suchanekj/-Sight/Schematics/Model/Robot.pdf

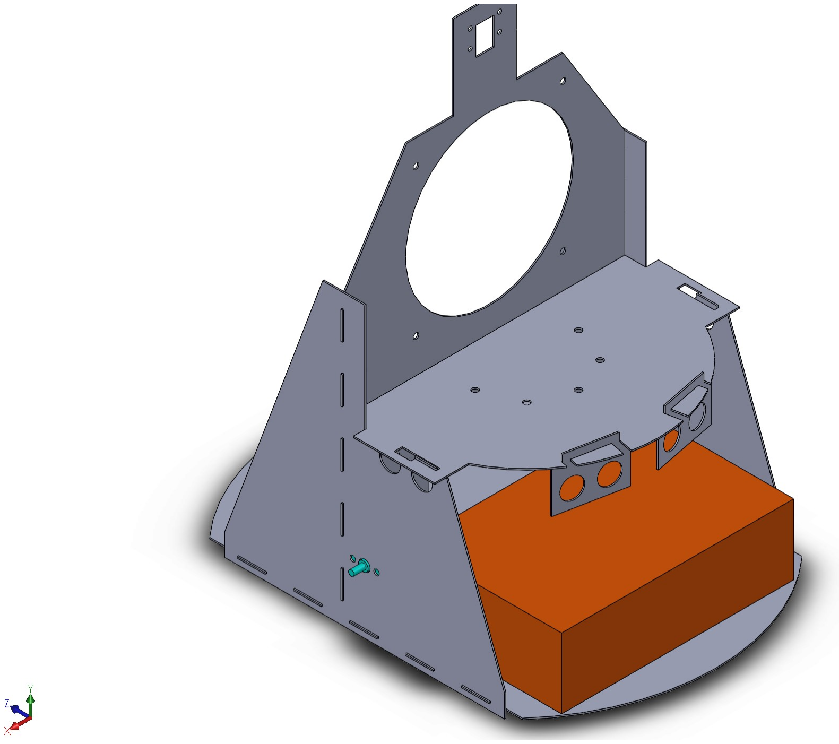
[picture p1: page 1]
