suchanekj/-Sight/Schematics/Circuit/board.png

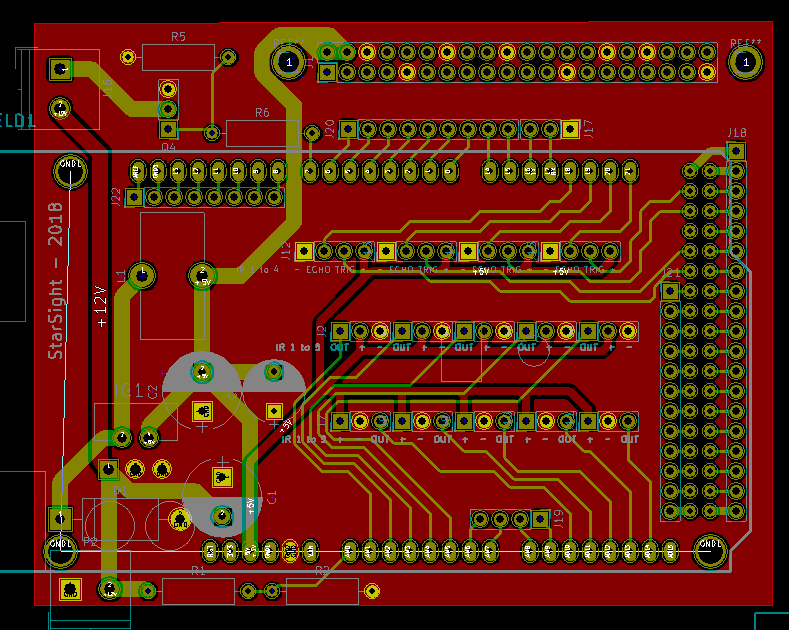
Schematics/Circuit/board.png
