suchanekj/-Sight/Schematics/Model/Robot.jpg

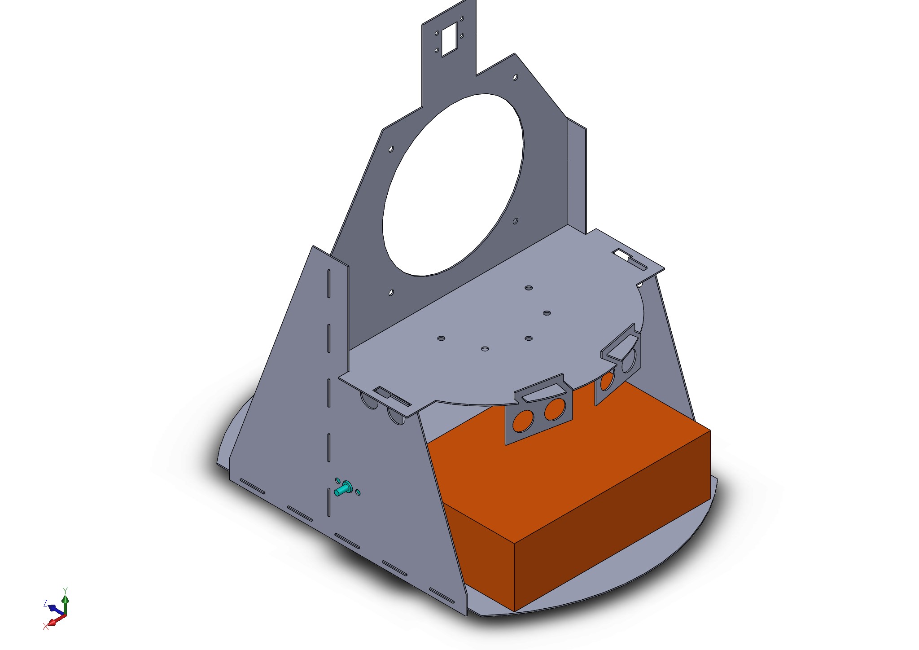
Schematics/Model/Robot.jpg
