suchanekj/-Sight/Schematics/Model/Robot.SLDASM

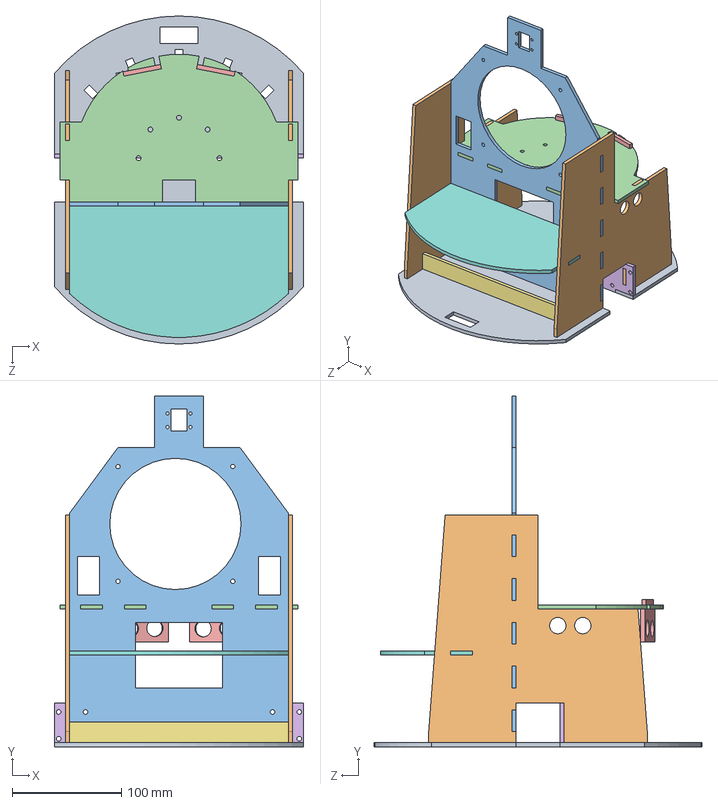
[picture p4: CAD file, 2018-03-03]
Schematics/Model/Robot.SLDASM
228.0 x 321.0 x 300.0 mm
Bottom
Side x 2
Center
IR_base
US_holder x 2
Motor_holder
Battery_holder
Board_holder
