suchanekj/-Sight/Schematics/Laser/Robot-rest.DXF

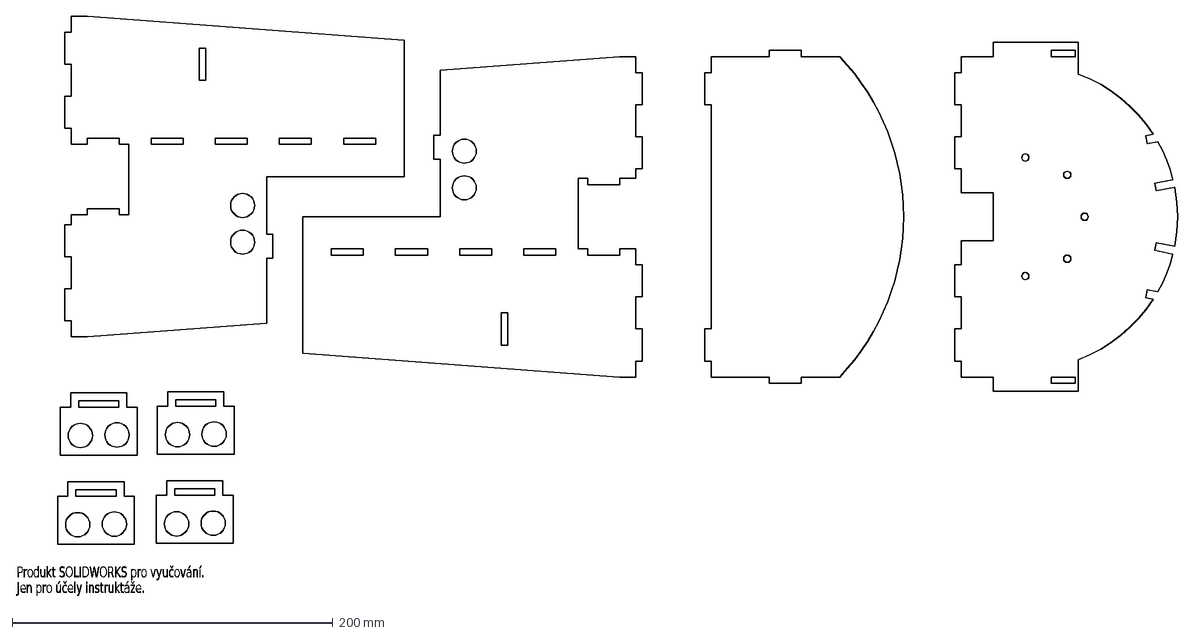
[picture p5: CAD file, 2018-03-03]
Schematics/Laser/Robot-rest.DXF
Produkt SOLIDWORKS pro vyučování.
Jen pro účely instruktáže.
