suchanekj/-Sight/Schematics/Model/US_holder.SLDPRT

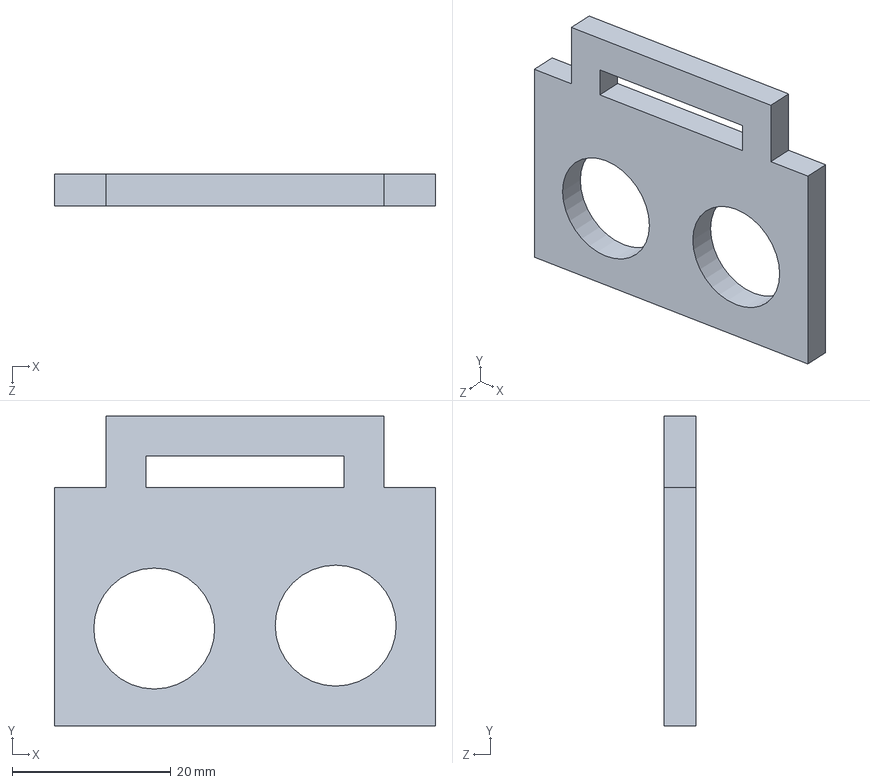
[picture p6: CAD file, 2018-03-03]
Schematics/Model/US_holder.SLDPRT
48.0 x 39.0 x 4.00 mm
