suchanekj/-Sight/Schematics/Laser/Robot-base-V2.DXF

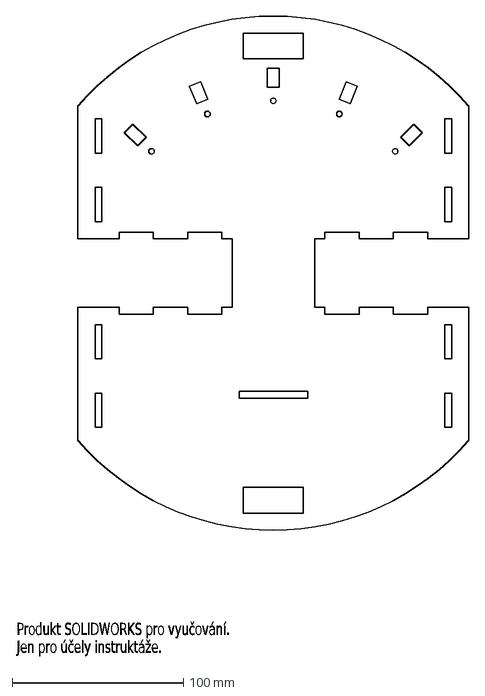
[picture p7: CAD file, 2018-03-03]
Schematics/Laser/Robot-base-V2.DXF
Produkt SOLIDWORKS pro vyučování.
Jen pro účely instruktáže.
