suchanekj/-Sight/Schematics/Model/IR_base.SLDPRT

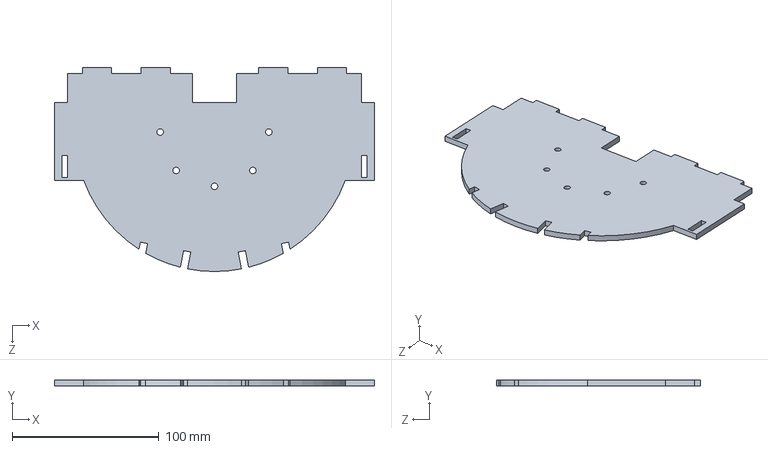
[picture p8: CAD file, 2018-03-03]
Schematics/Model/IR_base.SLDPRT
218.0 x 4.00 x 139.0 mm
