suchanekj/-Sight/Schematics/Laser/Robot-base.DXF

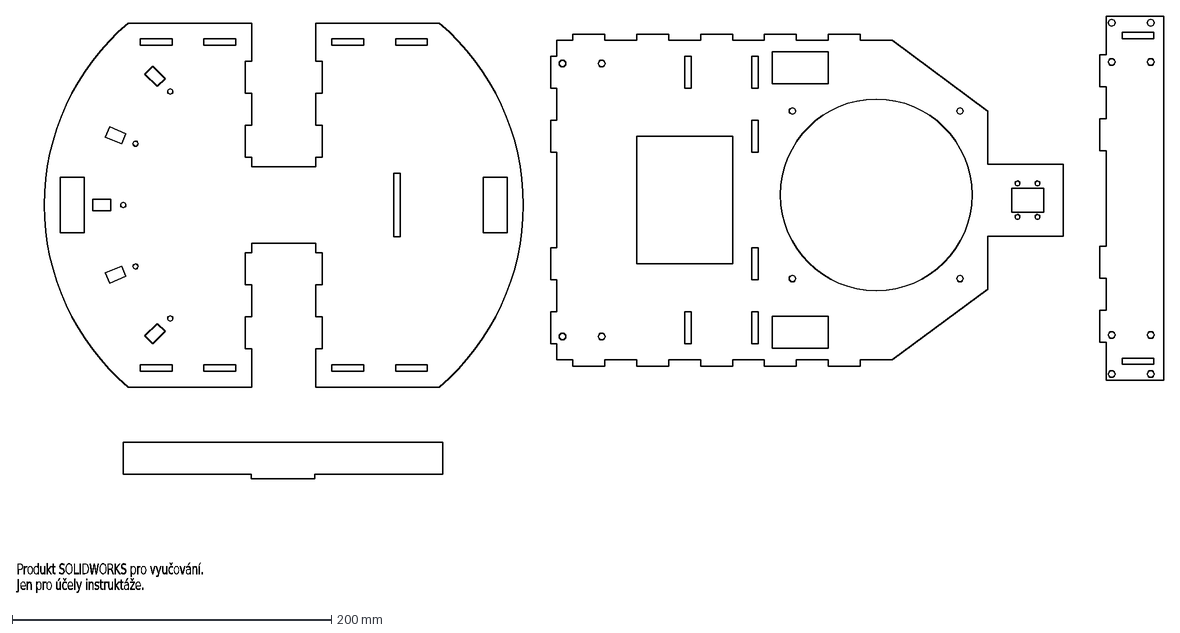
[picture p9: CAD file, 2018-03-03]
Schematics/Laser/Robot-base.DXF
Produkt SOLIDWORKS pro vyučování.
Jen pro účely instruktáže.
