suchanekj/-Sight/Schematics/Model/Center.SLDPRT

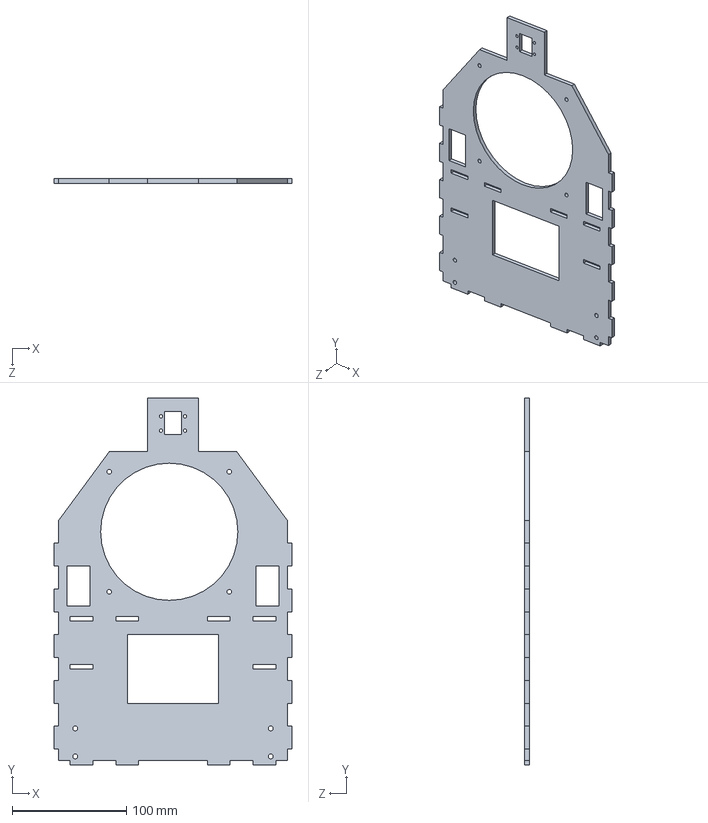
[picture p10: CAD file, 2018-03-03]
Schematics/Model/Center.SLDPRT
208.0 x 321.0 x 4.00 mm
