suchanekj/-Sight/Schematics/Model/Board.SLDPRT

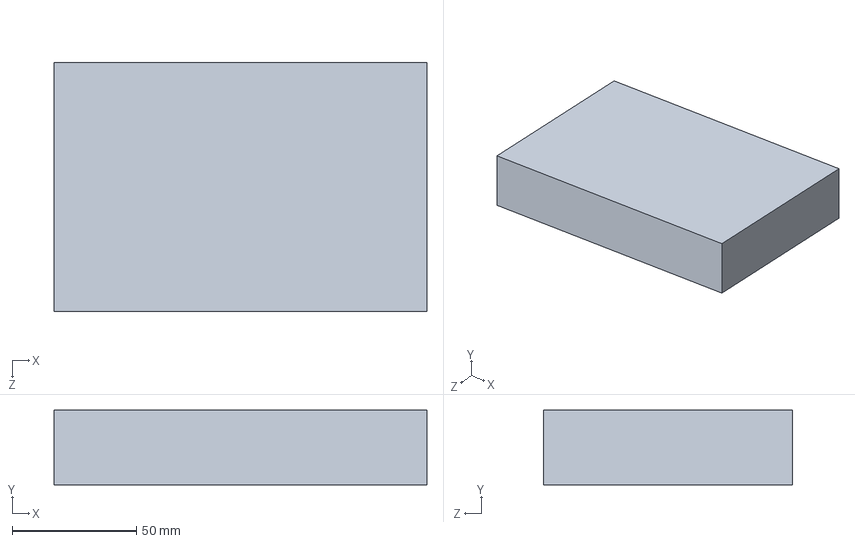
[picture p11: CAD file, 2018-03-03]
Schematics/Model/Board.SLDPRT
150.0 x 30.0 x 100.0 mm
