suchanekj/-Sight/Schematics/Model/Bottom.SLDPRT

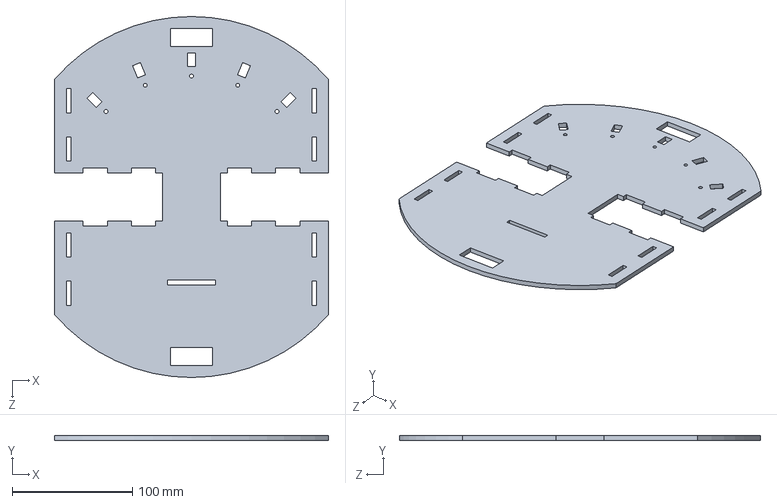
[picture p12: CAD file, 2018-03-03]
Schematics/Model/Bottom.SLDPRT
228.0 x 4.00 x 300.0 mm
