suchanekj/-Sight/Schematics/Model/Motor_holder.SLDPRT

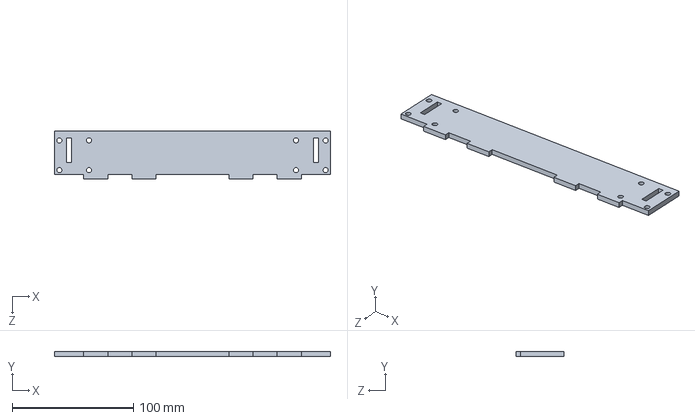
[picture p13: CAD file, 2018-03-03]
Schematics/Model/Motor_holder.SLDPRT
228.0 x 4.00 x 40.0 mm
