suchanekj/-Sight/Schematics/Model/Boards.SLDPRT

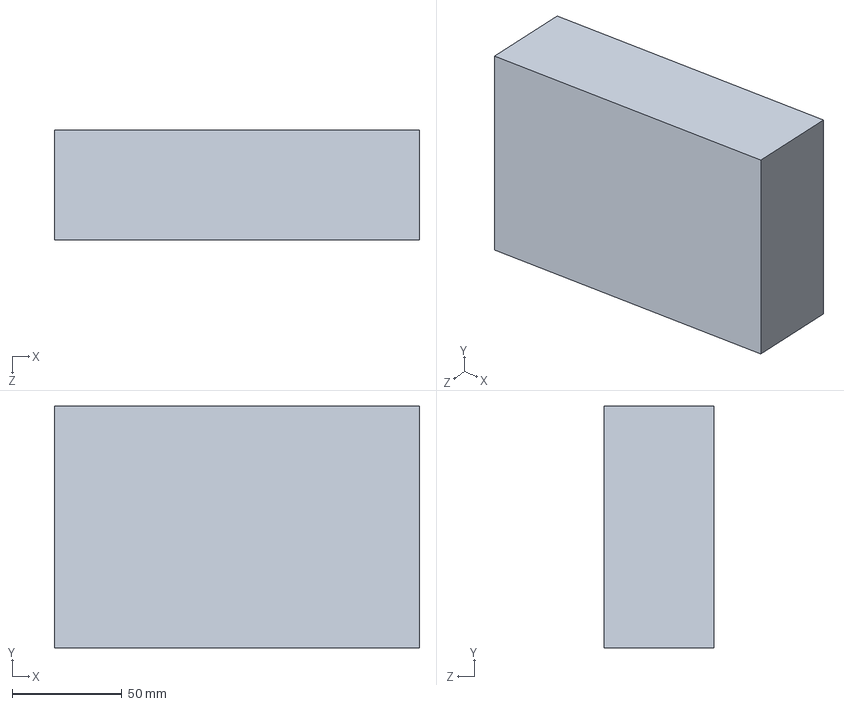
[picture p14: CAD file, 2018-03-03]
Schematics/Model/Boards.SLDPRT
166.0 x 110.0 x 50.0 mm
