suchanekj/-Sight/Schematics/Model/Battery_holder.SLDPRT

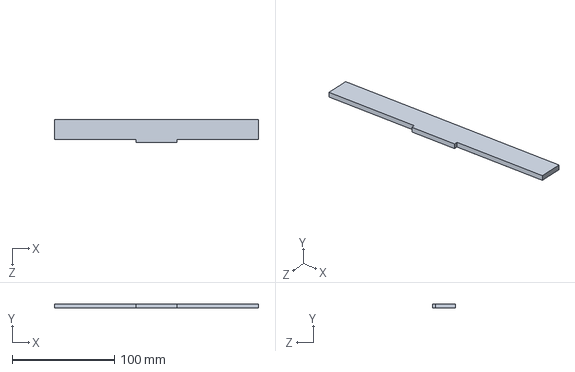
[picture p15: CAD file, 2018-03-03]
Schematics/Model/Battery_holder.SLDPRT
200.0 x 4.00 x 23.0 mm
