suchanekj/-Sight/Schematics/Model/Board_holder.SLDPRT

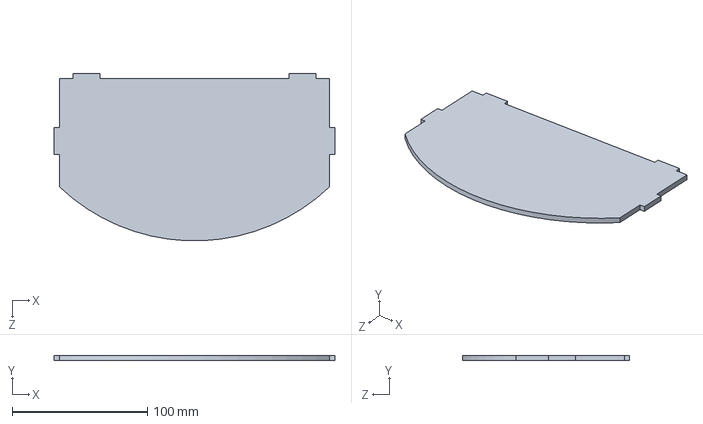
[picture p16: CAD file, 2018-03-03]
Schematics/Model/Board_holder.SLDPRT
208.0 x 4.00 x 123.9 mm
