suchanekj/-Sight/Schematics/Model/Side.SLDPRT

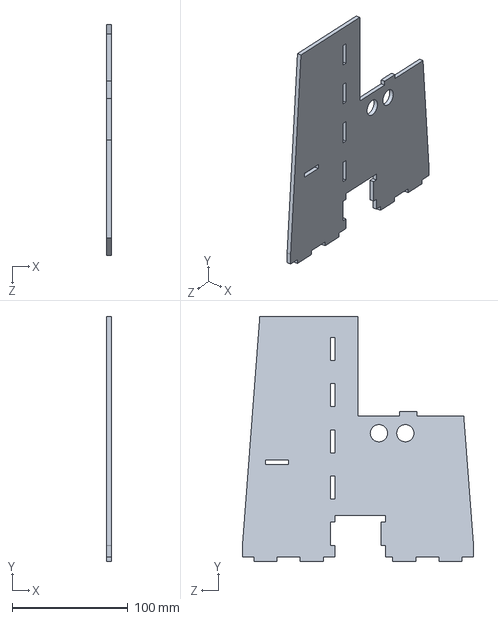
[picture p17: CAD file, 2018-03-03]
Schematics/Model/Side.SLDPRT
4.00 x 212.0 x 200.0 mm
