suchanekj/-Sight/Schematics/Model/Motor.SLDPRT

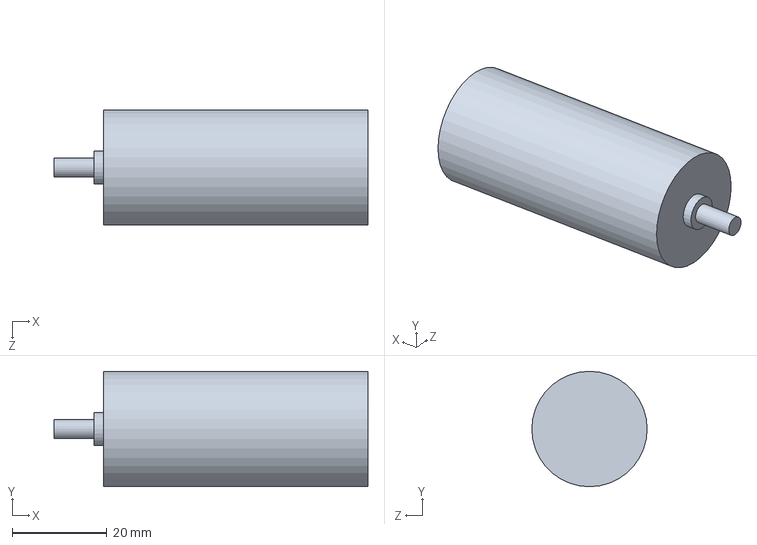
[picture p18: CAD file, 2018-01-22]
Schematics/Model/Motor.SLDPRT
66.4 x 24.4 x 24.4 mm
