suchanekj/-Sight/(list of files, cad)

Other CAD files:
Schematics/Model/Deska.SLDPRT
Schematics/Laser/Robot-base.SLDDRW
Schematics/Model/Robot-rest.SLDDRW
Schematics/Model/Robot.SLDDRW
