suchanekj/-Sight/Schematics/Circuit/Schematics.pdf

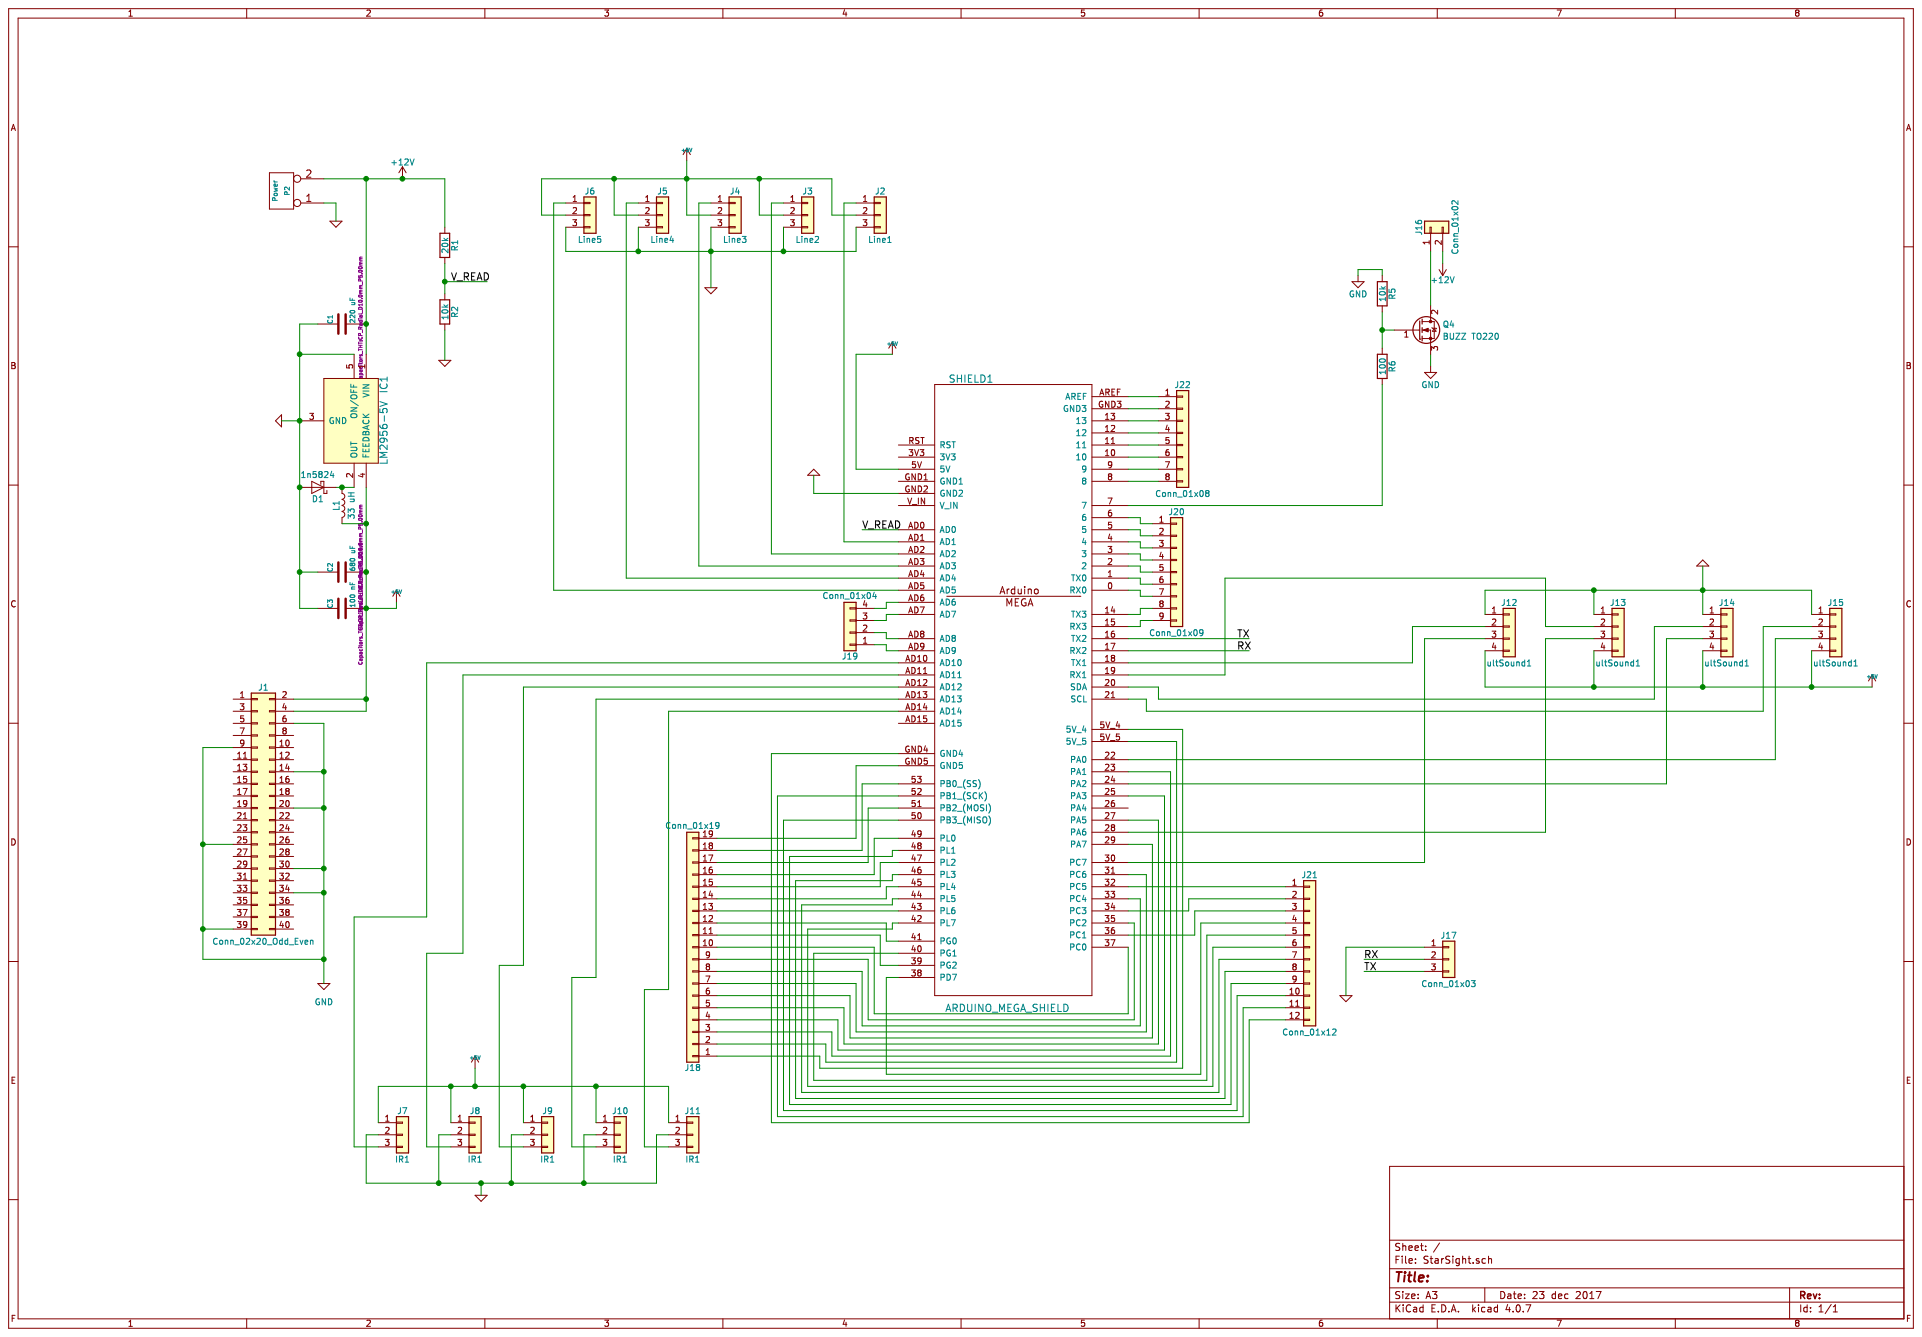
[picture p19: page 1]
