suchanekj/-Sight/Schematics/Circuit/StarSight.kicad_pcb

## KiCad design Schematics/Circuit/StarSight.kicad_pcb (2018-03-03)

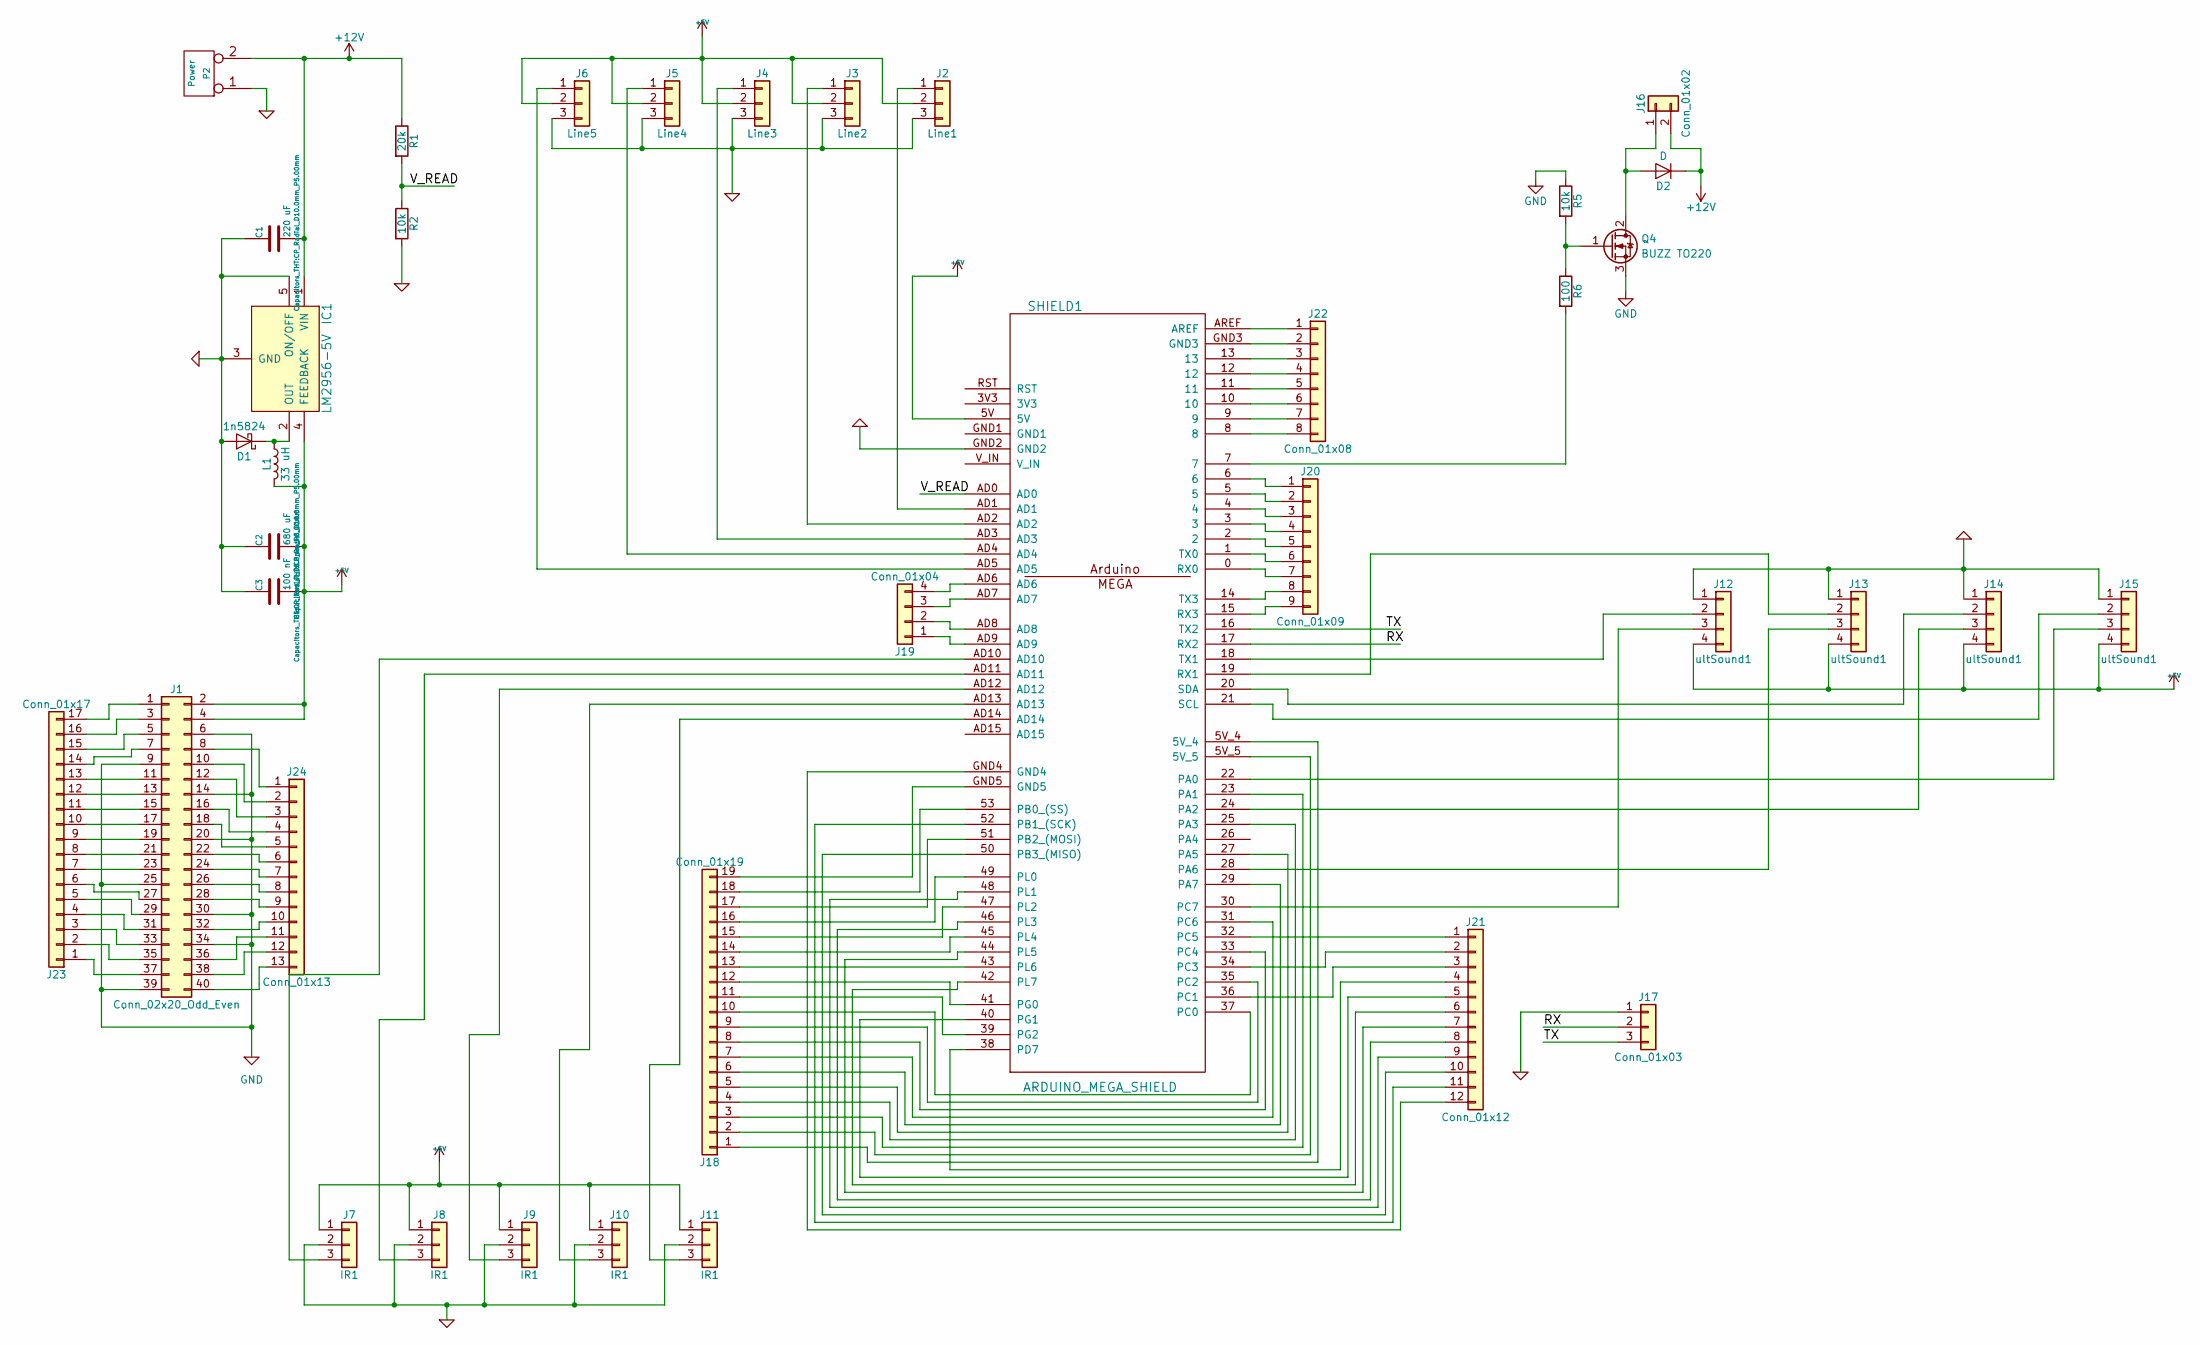
[picture p20: schematic StarSight.sch]

Parts:
C1: 220 uF; CP_Radial_D10.0mm_P5.00mm
C2: 680 uF; CP_Radial_D10.0mm_P5.00mm
C3: 100 nF; CP_Radial_D8.0mm_P5.00mm
D1: 1n5824; D_DO-201_P15.24mm_Horizontal
D2: D; D_DO-201_P15.24mm_Horizontal
IC1: LM2956-5V; TO170P470X1016X2092-5P
J1: Conn_02x20_Odd_Even; Pin_Header_Straight_2x20_Pitch2.54mm
J2: Line1; Pin_Header_Straight_1x03_Pitch2.54mm
J3: Line2; Pin_Header_Straight_1x03_Pitch2.54mm
J4: Line3; Pin_Header_Straight_1x03_Pitch2.54mm
J5: Line4; Pin_Header_Straight_1x03_Pitch2.54mm
J6: Line5; Pin_Header_Straight_1x03_Pitch2.54mm
J7, J8, J9, J10, J11: IR1; Pin_Header_Straight_1x03_Pitch2.54mm
J12, J13, J14, J15: ultSound1; Pin_Header_Straight_1x04_Pitch2.54mm
J16: Conn_01x02; TerminalBlock_Philmore_TB132_02x5mm_Straight
J17: Conn_01x03; Pin_Header_Straight_1x03_Pitch2.54mm
J18: Conn_01x19; Pin_Header_Straight_1x19_Pitch2.54mm
J19: Conn_01x04; Pin_Header_Straight_1x04_Pitch2.54mm
J20: Conn_01x09; Pin_Header_Straight_1x09_Pitch2.54mm
J21: Conn_01x12; Pin_Header_Straight_1x12_Pitch2.54mm
J22: Conn_01x08; Pin_Header_Straight_1x08_Pitch2.54mm
J23: Conn_01x17; Pin_Header_Straight_1x17_Pitch2.54mm
J24: Conn_01x13; Pin_Header_Straight_1x13_Pitch2.54mm
L1: 33 uH; L_Toroid_Vertical_L16.0mm_W8.0mm_P7.62mm
P2: Power; TerminalBlock_Philmore_TB132_02x5mm_Straight
Q4: BUZZ TO220; Pin_Header_Straight_1x03_Pitch2.54mm
R1: 20k; R_Axial_DIN0309_L9.0mm_D3.2mm_P12.70mm_Horizontal
R2, R5: 10k; R_Axial_DIN0309_L9.0mm_D3.2mm_P12.70mm_Horizontal
R6: 100; R_Axial_DIN0309_L9.0mm_D3.2mm_P12.70mm_Horizontal
SHIELD1: ARDUINO_MEGA_SHIELD

Connections:
+5V: C2.2, C3.2, IC1.4 (FEEDBACK), J1.2, J1.4, J2.2, J3.2, J4.2, J5.2, J6.2, J7.1, J8.1, J9.1, J10.1, J11.1, J12.4, J13.4, J14.4, J15.4, L1.2, SHIELD1.5V
+12V: C1.2, D2.1 (K), IC1.1 (VIN), J16.2, P2.2 (PM), R1.1
/RX: J17.2, SHIELD1.17 (RX2)
/TX: J17.3, SHIELD1.16 (TX2)
/V_READ: R1.2, R2.1, SHIELD1.AD0
GND: C1.1, C2.1, C3.1, D1.2 (A), IC1.3 (GND), IC1.5 (ON/OFF), J1.6, J1.9, J1.14, J1.20, J1.25, J1.30, J1.34, J1.39, J2.3, J3.3, J4.3, J5.3, J6.3, J7.2, J8.2, J9.2, J10.2, J11.2, J12.1, J13.1, J14.1, J15.1, J17.1, P2.1, Q4.3 (S), R2.2, R5.1, SHIELD1.GND2
unnamed: D1.1 (K), IC1.2 (OUT), L1.1
unnamed: D2.2 (A), J16.1, Q4.2 (D)
unnamed: J1.1, J23.17
unnamed: J1.3, J23.16
unnamed: J1.5, J23.15
unnamed: J1.7, J23.14
unnamed: J1.8, J24.1
unnamed: J1.10, J24.2
unnamed: J1.11, J23.13
unnamed: J1.12, J24.3
unnamed: J1.13, J23.12
unnamed: J1.15, J23.11
unnamed: J1.16, J24.4
unnamed: J1.17, J23.10
unnamed: J1.18, J24.5
unnamed: J1.19, J23.9
unnamed: J1.21, J23.8
unnamed: J1.22, J24.6
unnamed: J1.23, J23.7
unnamed: J1.24, J24.7
unnamed: J1.26, J24.8
unnamed: J1.27, J23.6
unnamed: J1.28, J24.9
unnamed: J1.29, J23.5
unnamed: J1.31, J23.4
unnamed: J1.32, J24.10
unnamed: J1.33, J23.3
unnamed: J1.35, J23.2
unnamed: J1.36, J24.11
unnamed: J1.37, J23.1
unnamed: J1.38, J24.12
unnamed: J1.40, J24.13
unnamed: J2.1, SHIELD1.AD1
unnamed: J3.1, SHIELD1.AD2
unnamed: J4.1, SHIELD1.AD3
unnamed: J5.1, SHIELD1.AD4
unnamed: J6.1, SHIELD1.AD5
unnamed: J7.3, SHIELD1.AD10
unnamed: J8.3, SHIELD1.AD11
unnamed: J9.3, SHIELD1.AD12
unnamed: J10.3, SHIELD1.AD13
unnamed: J11.3, SHIELD1.AD14
unnamed: J12.2, SHIELD1.18 (TX1)
unnamed: J12.3, SHIELD1.30 (PC7)
unnamed: J13.2, SHIELD1.19 (RX1)
unnamed: J13.3, SHIELD1.28 (PA6)
unnamed: J14.2, SHIELD1.20 (SDA)
unnamed: J14.3, SHIELD1.24 (PA2)
unnamed: J15.2, SHIELD1.21 (SCL)
unnamed: J15.3, SHIELD1.22 (PA0)
unnamed: J18.1, SHIELD1.5V_4
unnamed: J18.2, SHIELD1.5V_5
unnamed: J18.3, SHIELD1.23 (PA1)
unnamed: J18.4, SHIELD1.25 (PA3)
unnamed: J18.5, SHIELD1.27 (PA5)
unnamed: J18.6, SHIELD1.29 (PA7)
unnamed: J18.7, SHIELD1.31 (PC6)
unnamed: J18.8, SHIELD1.33 (PC4)
unnamed: J18.9, SHIELD1.35 (PC2)
unnamed: J18.10, SHIELD1.37 (PC0)
unnamed: J18.11, SHIELD1.39 (PG2)
unnamed: J18.12, SHIELD1.41 (PG0)
unnamed: J18.13, SHIELD1.43 (PL6)
unnamed: J18.14, SHIELD1.45 (PL4)
unnamed: J18.15, SHIELD1.47 (PL2)
unnamed: J18.16, SHIELD1.49 (PL0)
unnamed: J18.17, SHIELD1.51 (PB2_(MOSI))
unnamed: J18.18, SHIELD1.53 (PB0_(SS))
unnamed: J18.19, SHIELD1.GND5
unnamed: J19.1, SHIELD1.AD9
unnamed: J19.2, SHIELD1.AD8
unnamed: J19.3, SHIELD1.AD7
unnamed: J19.4, SHIELD1.AD6
unnamed: J20.1, SHIELD1.6
unnamed: J20.2, SHIELD1.5
unnamed: J20.3, SHIELD1.4
unnamed: J20.4, SHIELD1.3
unnamed: J20.5, SHIELD1.2
unnamed: J20.6, SHIELD1.1 (TX0)
unnamed: J20.7, SHIELD1.0 (RX0)
unnamed: J20.8, SHIELD1.14 (TX3)
unnamed: J20.9, SHIELD1.15 (RX3)
unnamed: J21.1, SHIELD1.32 (PC5)
unnamed: J21.2, SHIELD1.34 (PC3)
unnamed: J21.3, SHIELD1.36 (PC1)
unnamed: J21.4, SHIELD1.38 (PD7)
unnamed: J21.5, SHIELD1.40 (PG1)
unnamed: J21.6, SHIELD1.42 (PL7)
unnamed: J21.7, SHIELD1.44 (PL5)
unnamed: J21.8, SHIELD1.46 (PL3)
unnamed: J21.9, SHIELD1.48 (PL1)
unnamed: J21.10, SHIELD1.50 (PB3_(MISO))
unnamed: J21.11, SHIELD1.52 (PB1_(SCK))
unnamed: J21.12, SHIELD1.GND4
unnamed: J22.1, SHIELD1.AREF
unnamed: J22.2, SHIELD1.GND3
unnamed: J22.3, SHIELD1.13
unnamed: J22.4, SHIELD1.12
unnamed: J22.5, SHIELD1.11
unnamed: J22.6, SHIELD1.10
unnamed: J22.7, SHIELD1.9
unnamed: J22.8, SHIELD1.8
unnamed: Q4.1 (G), R5.2, R6.1
unnamed: R6.2, SHIELD1.7

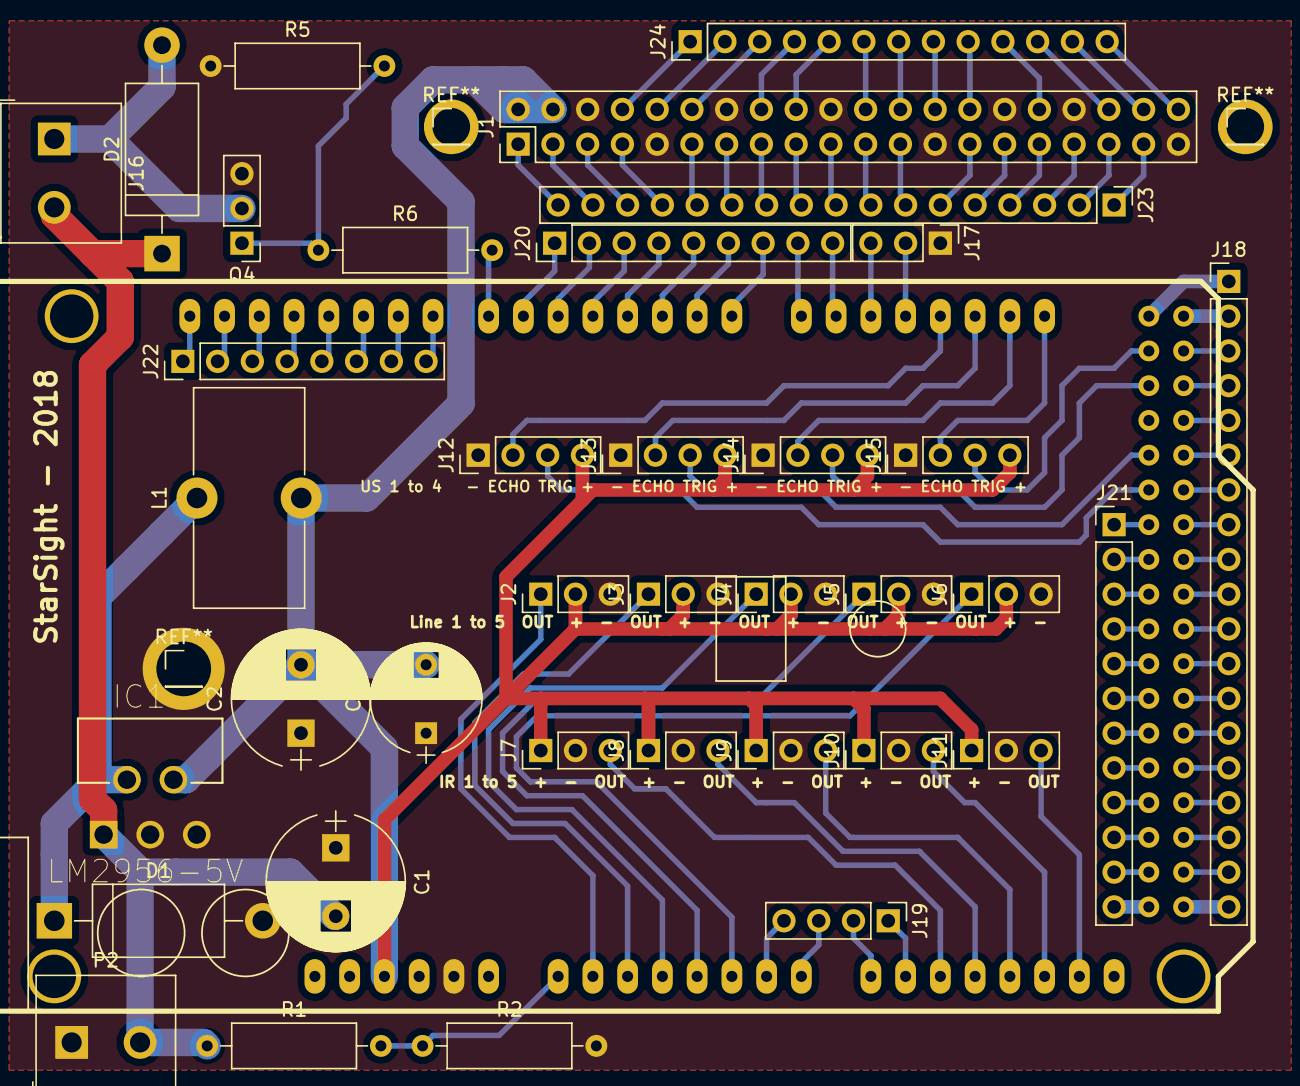
[picture p21: board StarSight.kicad_pcb from above]

Board: 2 copper layers, 38 parts (0 on the bottom side), 110 nets.
