suchanekj/-Sight/Schematics/Circuit/StarSight_1layer.kicad_pcb

## KiCad design Schematics/Circuit/StarSight_1layer.kicad_pcb (2018-02-20)

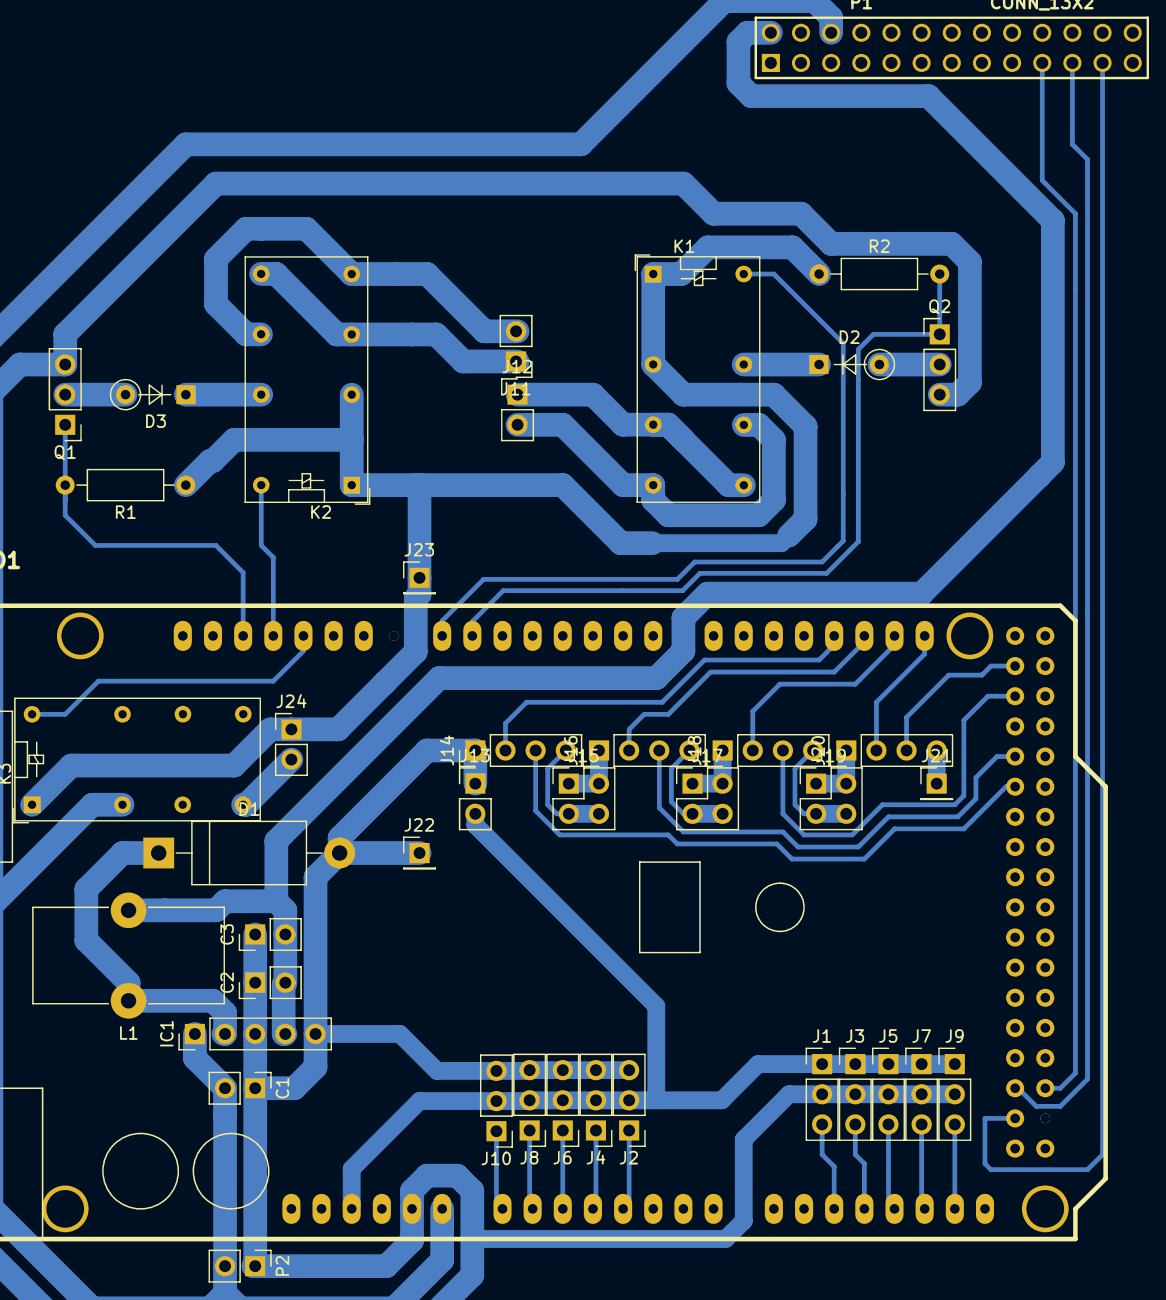
[picture p22: board StarSight_1layer.kicad_pcb from above]

Board: 2 copper layers, 42 parts (0 on the bottom side), 48 nets.

Parts:
C1, C2: 10 uF; Pin_Header_Straight_1x02_Pitch2.54mm
C3: 100 nF; Pin_Header_Straight_1x02_Pitch2.54mm
D1: 1n5824; D_DO-201_P15.24mm_Horizontal
D2, D3: D; D_DO-35_SOD27_P5.08mm_Vertical_KathodeUp
IC1: LM2956-5V; Pin_Header_Straight_1x05_Pitch2.54mm
J1, J3, J5, J7, J9: IR1; Pin_Header_Straight_1x03_Pitch2.54mm
J2: Line5; Pin_Header_Straight_1x03_Pitch2.54mm
J4: Line4; Pin_Header_Straight_1x03_Pitch2.54mm
J6: Line3; Pin_Header_Straight_1x03_Pitch2.54mm
J8: Line2; Pin_Header_Straight_1x03_Pitch2.54mm
J10: Line1; Pin_Header_Straight_1x03_Pitch2.54mm
J11, J12, J13, J24: Conn_01x02; Pin_Header_Straight_1x02_Pitch2.54mm
J14, J16, J18, J20: ultSound1; Pin_Header_Straight_1x04_Pitch2.54mm
J15, J17, J19: Conn_02x02_Counter_Clockwise; Pin_Header_Straight_2x02_Pitch2.54mm
J21, J22, J23: Conn_01x01; Pin_Header_Straight_1x01_Pitch2.54mm
K1, K2, K3: RELAY; Relay_DPDT_Omron_G5V-2
L1: 33 uH; L_Toroid_Vertical_L16.0mm_W8.0mm_P7.62mm
P1: CONN_13X2; pin_array_13x2
P2: Power; Pin_Header_Straight_1x02_Pitch2.54mm
Q1, Q2: Q_NMOS_GDS; Pin_Header_Straight_1x03_Pitch2.54mm
R1, R2: 10k; R_Axial_DIN0207_L6.3mm_D2.5mm_P10.16mm_Horizontal
SHIELD1: ARDUINO_MEGA_SHIELD

Connections:
+5V: J1.1, J2.2, J3.1, J4.2, J5.1, J6.2, J7.1, J8.2, J9.1, J10.2, J13.2, SHIELD1.5V
+12V: C1.2, IC1.1, K3.4, P2.2, Q1.3, Q2.3, SHIELD1.V_IN
/GPIO9(MISO): P1.21, SHIELD1.50
/GPIO10(MOSI): P1.19, SHIELD1.51
/GPIO11(SCLK): P1.23, SHIELD1.52
GND: C1.1, C2.1, C3.1, D1.2, IC1.3, IC1.5, J1.2, J2.3, J3.2, J4.3, J5.2, J6.3, J7.2, J8.3, J9.2, J10.3, J13.1, J14.1, J22.1, P1.6, P2.1, SHIELD1.GND2
unnamed: C2.2, C3.2, IC1.4, L1.2, P1.2
unnamed: D1.1, IC1.2, L1.1
unnamed: D2.1, K1.13
unnamed: D2.2, Q2.2
unnamed: D3.1, K2.13
unnamed: D3.2, Q1.2
unnamed: J1.3, SHIELD1.AD10
unnamed: J2.1, SHIELD1.AD4
unnamed: J3.3, SHIELD1.AD11
unnamed: J4.1, SHIELD1.AD3
unnamed: J5.3, SHIELD1.AD12
unnamed: J6.1, SHIELD1.AD2
unnamed: J7.3, SHIELD1.AD13
unnamed: J8.1, SHIELD1.AD1
unnamed: J9.3, SHIELD1.AD14
unnamed: J10.1, SHIELD1.AD0
unnamed: J11.1, K2.6, K2.9
unnamed: J11.2, K2.8, K2.11
unnamed: J12.1, K1.6, K1.9
unnamed: J12.2, K1.8, K1.11
unnamed: J14.2, SHIELD1.18
unnamed: J14.3, SHIELD1.30
unnamed: J14.4, J15.3, J15.4
unnamed: J15.1, J15.2, J16.1
unnamed: J16.2, SHIELD1.19
unnamed: J16.3, SHIELD1.28
unnamed: J16.4, J17.3, J17.4
unnamed: J17.1, J17.2, J18.1
unnamed: J18.2, SHIELD1.20
unnamed: J18.3, SHIELD1.24
unnamed: J18.4, J19.3, J19.4
unnamed: J19.1, J19.2, J20.1
unnamed: J20.2, SHIELD1.21
unnamed: J20.3, SHIELD1.22
unnamed: J20.4, J21.1
unnamed: J23.1, J24.1, K1.1, K1.4, K2.1, K2.4, K3.1, R1.1, R2.1
unnamed: J24.2, K3.8
unnamed: K1.16, SHIELD1.7
unnamed: K2.16, SHIELD1.12
unnamed: K3.16, SHIELD1.11
unnamed: Q1.1, R1.2, SHIELD1.13
unnamed: Q2.1, R2.2, SHIELD1.6
