suchanekj/-Sight/StarSight/helperFunctions.h

#ifndef MAIN_HELPERFUNCTIONS_H
#define MAIN_HELPERFUNCTIONS_H

#include "math.h"
#include "config.h"

float angleToLine(int a, int b);

int median(int *field, int len);

#endif //MAIN_HELPERFUNCTIONS_H
