suchanekj/-Sight/(commit log)

2017-12-17 Add last year code and schematic base
    [StarSight.sch]
2017-12-23 Add the rest of the schematic
    [StarSight.sch]
2017-12-24 Add pcb layout
    [StarSight.kicad_pcb, StarSight.sch]
2017-12-25 Fix pcb
    [StarSight.kicad_pcb]
2017-12-29 Edit pcb
    [StarSight.kicad_pcb]
2017-12-29 Add switched regulator and motors
    [StarSight.kicad_pcb, StarSight.sch]
2017-12-29 Fix footprint missing
    [StarSight.sch]
2017-12-30 Fix pcb power suply and motors
    [StarSight.kicad_pcb, StarSight.sch]
2018-01-21 Add single sided version of the circuit
    [StarSight_1layer.kicad_pcb, StarSight_1layer.sch]
2018-01-22 Add model
    [Boards.SLDPRT, Bottom.SLDPRT, Center.SLDPRT, IR_base.SLDPRT, Motor.SLDPRT, Robot.SLDASM, Side.SLDPRT]
2018-02-04 Add sensor placeholders
    [Center.SLDPRT, IR_base.SLDPRT, Robot.SLDASM, Side.SLDPRT, US_holder.SLDPRT]
2018-02-12 Change inductor footprint
    [StarSight_1layer.kicad_pcb, StarSight_1layer.sch]
2018-02-12 Add fan
    [StarSight_1layer.kicad_pcb, StarSight_1layer.sch]
2018-02-12 Edit fan relay
    [StarSight_1layer.kicad_pcb, StarSight_1layer.sch]
2018-02-19 Reroute main circuit board to fit 1 dm^2
    [StarSight.kicad_pcb]
2018-02-19 Fix relays and board size
    [StarSight.kicad_pcb, StarSight.sch]
2018-02-20 Added MonoVision Odometry
2018-02-20 Edit board thickness in the model
    [Bottom.SLDPRT, Center.SLDPRT, IR_base.SLDPRT, Robot.SLDASM, Side.SLDPRT, US_holder.SLDPRT]
2018-02-22 Export schematics and board
2018-02-23 fix IR base
    [Boards.SLDPRT, IR_base.SLDPRT, Robot.SLDASM]
2018-02-25 Edit board - remove drivers, add pins
    [StarSight.kicad_pcb, StarSight_1layer.kicad_pcb, StarSight_1layer.sch, _saved_StarSight.sch]
2018-02-25 Edit circuit exports
    [StarSight.kicad_pcb, StarSight.sch, _saved_StarSight.sch]
2018-02-25 Edit robot model and add exports for laser
    [Battery_holder.SLDPRT, Board.SLDPRT, Board_holder.SLDPRT, Boards.SLDPRT, Bottom.SLDPRT, Center.SLDPRT, Deska.SLDPRT, IR_base.SLDPRT]
2018-02-25 Add pins for raspberry and few circuit fixes
    [StarSight.kicad_pcb, StarSight.sch]
2018-03-03 Added RoboModel arduino input
2018-03-04 Add new arduino code
2018-03-06 Add forgotten arduino files
2018-03-07 Add battery voltage reading
2018-03-07 Add new driver board
2018-03-07 Add led signal
2018-03-08 Testing sensors with motors
